jasonnovak/appliance-display-sensor/hardware/mount/photos/README.md

# Build photos

Supplied by the project owner for the model release. Full-resolution copies retain
the original pixels; EXIF/XMP/IPTC/comment metadata has been removed for publication.
The supplied originals have not been modified.

## Assembled view — suggested listing cover

Assembled mount, cable cover and ventilated Pi lid

## Top view with covers fitted

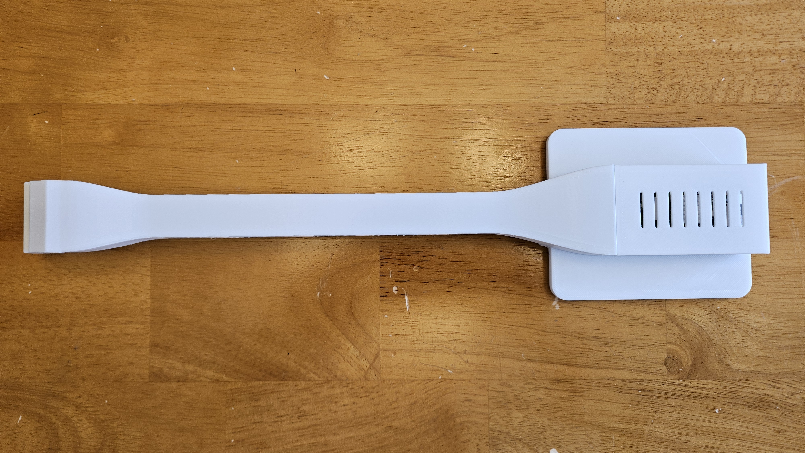
[picture p3: hardware/mount/photos/appliance-display-sensor-3.jpg]
Complete mount viewed from above


## Electronics and cable routing

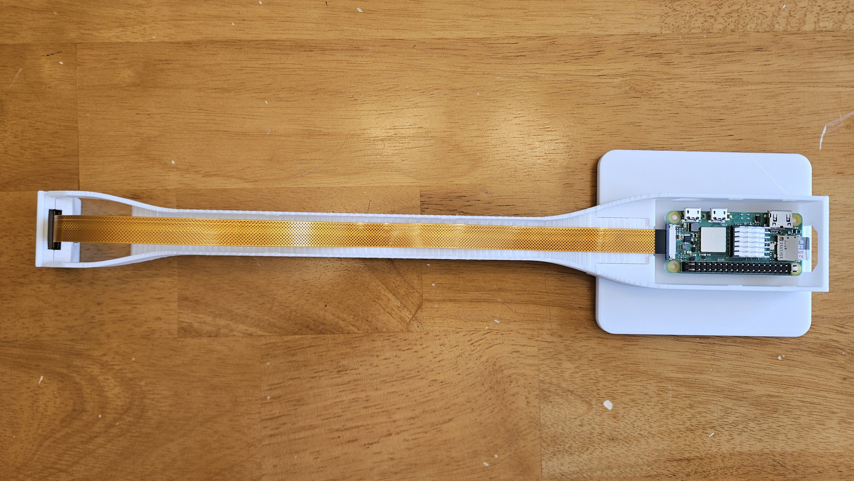
[picture p4: hardware/mount/photos/appliance-display-sensor-2.jpg]
Pi, heatsink and ribbon cable with covers removed


## Printed components

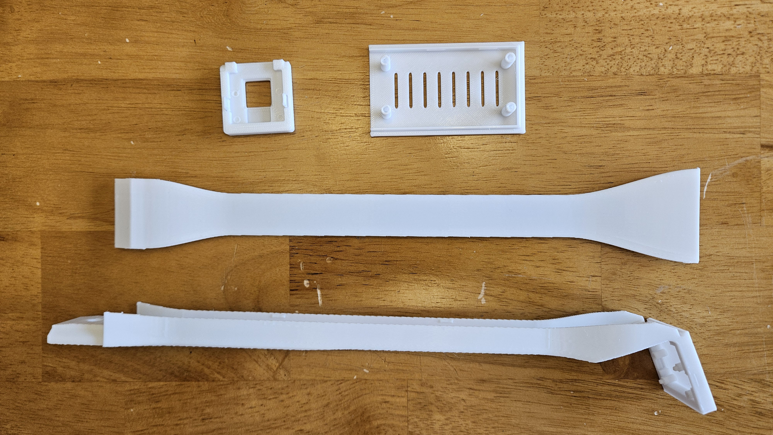
[picture p5: hardware/mount/photos/appliance-display-sensor-1.jpg]
Arm, cable cover, Pi lid and camera cover


## Camera end

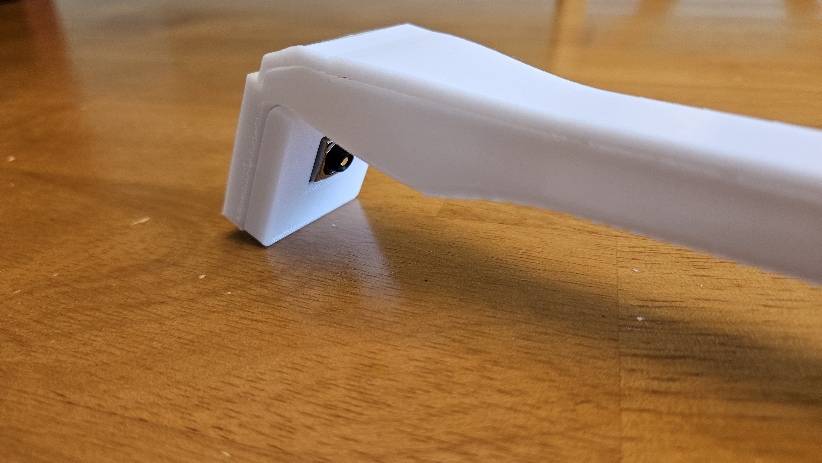
[picture p6: hardware/mount/photos/appliance-display-sensor-4.jpg]
Camera opening and fitted cover
