jasonnovak/appliance-display-sensor/hardware/mount/LICENSING.md

# Mount and case licensing

Copyright 2026 Appliance Display Sensor contributors.

SPDX-License-Identifier: CERN-OHL-P-2.0

Original mount and case designs, CAD sources and design-generation scripts,
drawings, print exports and accompanying design documentation in this directory
and its subdirectories are licensed under CERN-OHL-P-2.0. See LICENSE.
This includes STL, STEP, FCStd and project-authored design content in 3MF files.
Third-party reference files, printer/material profiles and software retain their
own licenses and notices. This declaration does not relicense those materials.

Include LICENSE and this notice when sharing the designs, including standalone
export sets. The designs are supplied without warranty; see LICENSE.
