jasonnovak/appliance-display-sensor/hardware/mount/cad/05-main-arm-overlap-nose.step

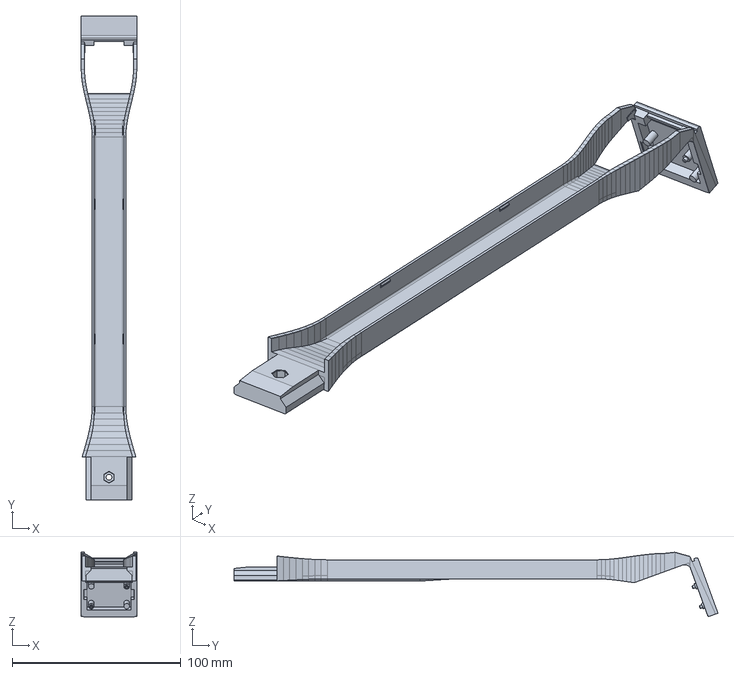
[picture p10: CAD file, 2026-11-11]
hardware/mount/cad/05-main-arm-overlap-nose.step
33.0 x 287.2 x 38.3 mm
