jasonnovak/appliance-display-sensor/hardware/mount/cad/04-curved-cover-closed-end.step

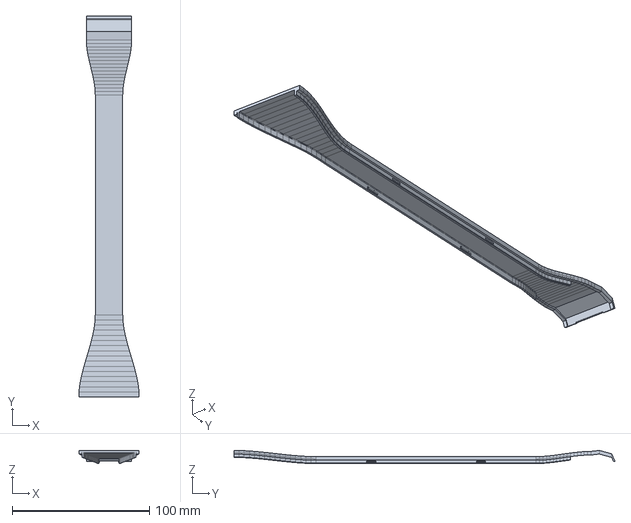
[picture p11: CAD file, 2026-11-11]
hardware/mount/cad/04-curved-cover-closed-end.step
44.0 x 277.2 x 9.60 mm
