jasonnovak/appliance-display-sensor/hardware/mount/print-project/appliance-display-mount.3mf

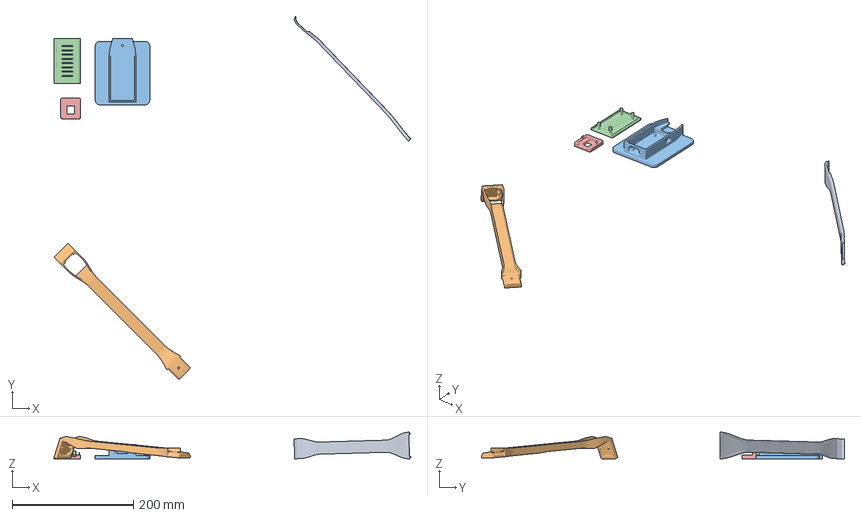
[picture p12: CAD file, 2026-11-11]
hardware/mount/print-project/appliance-display-mount.3mf
588.8 x 599.1 x 44.0 mm
04-curved-cover-closed-end.stl
05-main-arm-overlap-nose.stl
01-base-recessed-head.stl
02-pi-lid.stl
03-camera-cover-thicker-front.stl
