jasonnovak/appliance-display-sensor/hardware/mount/cad/03-camera-cover-thicker-front.step

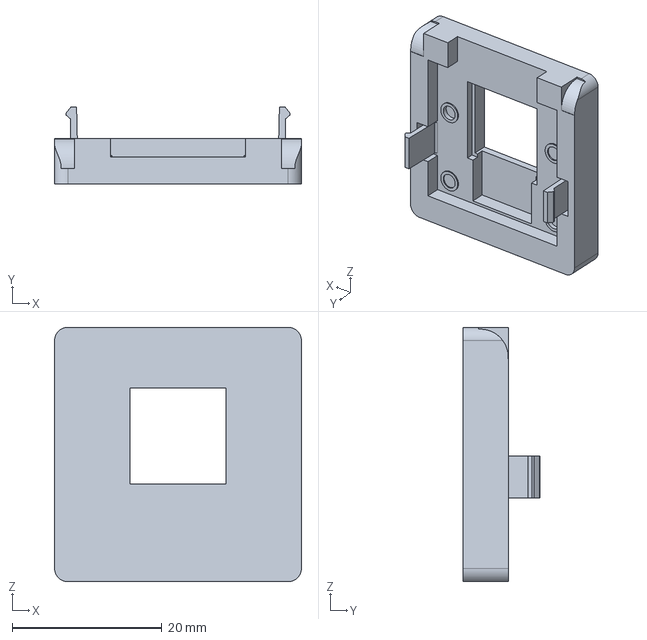
[picture p13: CAD file, 2026-11-11]
hardware/mount/cad/03-camera-cover-thicker-front.step
33.0 x 10.3 x 34.0 mm
