jasonnovak/appliance-display-sensor/hardware/mount/cad/01-base-recessed-head.step

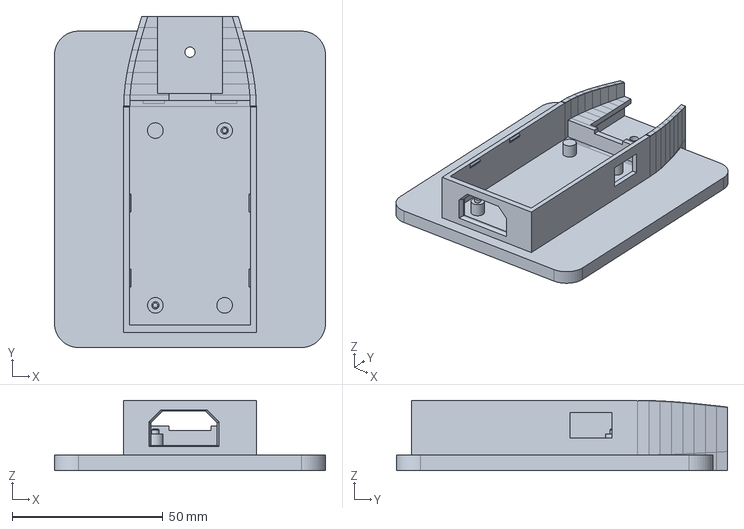
[picture p14: CAD file, 2026-11-11]
hardware/mount/cad/01-base-recessed-head.step
90.0 x 109.8 x 23.4 mm
