jasonnovak/appliance-display-sensor/hardware/mount/cad/02-pi-lid.step

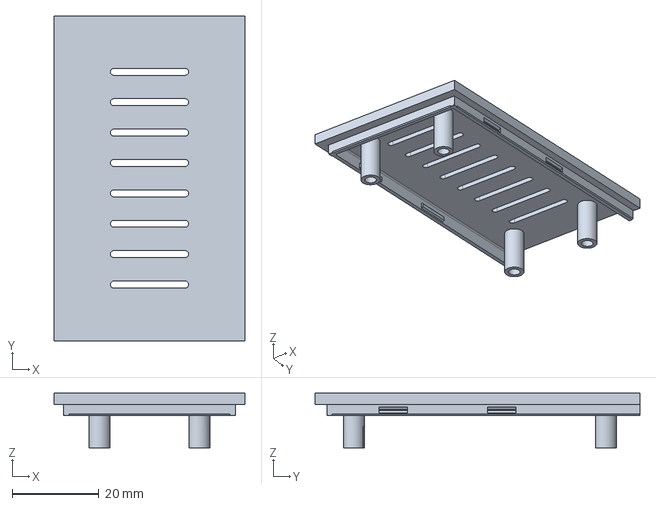
[picture p15: CAD file, 2026-11-11]
hardware/mount/cad/02-pi-lid.step
44.0 x 74.8 x 12.6 mm
