jasonnovak/appliance-display-sensor/(list of files, cad)

Other CAD files:
hardware/mount/stl/01-base-recessed-head.stl
hardware/mount/stl/02-pi-lid.stl
hardware/mount/stl/03-camera-cover-thicker-front.stl
hardware/mount/stl/04-curved-cover-closed-end.stl
hardware/mount/stl/05-main-arm-overlap-nose.stl
