jasonnovak/appliance-display-sensor/software/appliance-display-sensor/src/appliance_display_sensor/inputs/image_file.py

from __future__ import annotations

from pathlib import Path

import cv2
import numpy as np


def read_image(path: str | Path) -> np.ndarray:
    image_path = Path(path)
    image = cv2.imread(str(image_path), cv2.IMREAD_COLOR)
    if image is None:
        raise ValueError(f"could not read image: {image_path}")
    return image
