jasonnovak/appliance-display-sensor/software/appliance-display-sensor/configs/example-picamera2.yaml

# First camera setup only: synthetic boxes; calibrate before enabling MQTT.
# Trusted LAN only. Auto exposure/focus are starting settings, not validated optics.
version: 1
device:
  identifier: appliance-display-01
  name: Appliance Display
  appliance_type: null
input:
  type: picamera2
  camera_index: 0
  resolution:
  - 2304
  - 1296
  rotation: 0
  autofocus_mode: auto
  warmup_seconds: 2.0
  frame_interval_seconds: 1.0
  capture_burst_count: 4
display:
  decoder: seven_segment
  roi:
  - 0
  - 0
  - 420
  - 150
  digit_boxes:
  - - 25
    - 15
    - 70
    - 120
  - - 175
    - 15
    - 70
    - 120
  - - 285
    - 15
    - 70
    - 120
  colon_box:
  - 120
  - 38
  - 24
  - 74
  colon_after: 1
  channel: blue
  threshold:
    method: fixed
    value: 160
  min_segment_fill: 0.3
  colon_min_fill: 0.02
  min_digit_confidence: 0.72
  segment_thickness_ratio: 0.12
  segment_slant_ratio: 0.0
  allowed_glyphs:
  - blank
  - '0'
  - '1'
  - '2'
  - '3'
  - '4'
  - '5'
  - '6'
  - '7'
  - '8'
  - '9'
  - E
  - n
  - d
semantics:
  countdown_format: auto
  no_colon_unit: minutes
  terminal_texts:
  - End
stability:
  confirmations: 2
  latch_completion_until_next_cycle: true
  unknown_grace_seconds: 15
diagnostics:
  transition_directory: null
calibration:
  enabled: true
  host: 0.0.0.0
  port: 8090
mqtt:
  enabled: false
  host: homeassistant.local
  port: 1883
  username: null
  password: null
  base_topic: appliance_display_sensor/appliance-display-01
  discovery_prefix: homeassistant
